andrejsoucek/louvre-motor/mount.stl

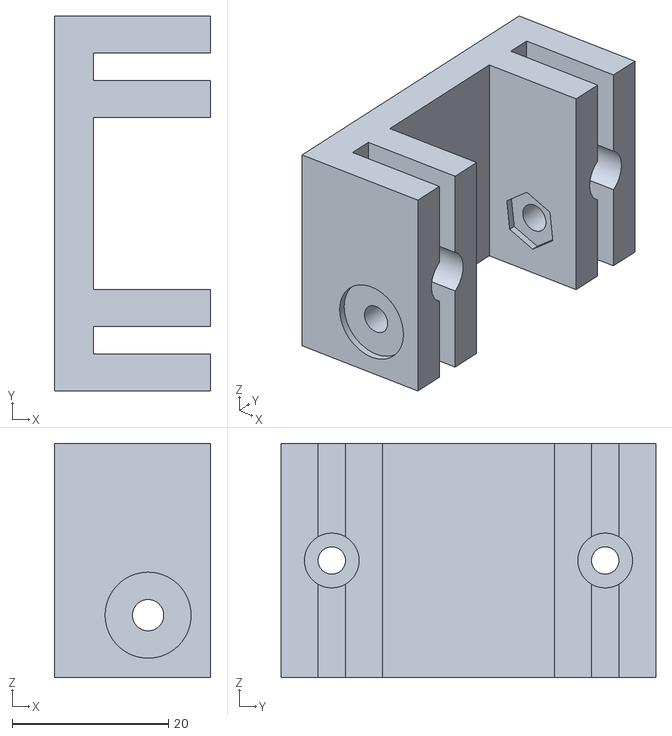
[picture p1: CAD file, 2026-07-16]
mount.stl
20.0 x 48.0 x 30.0
