andrejsoucek/louvre-motor/adapter-motor.stl

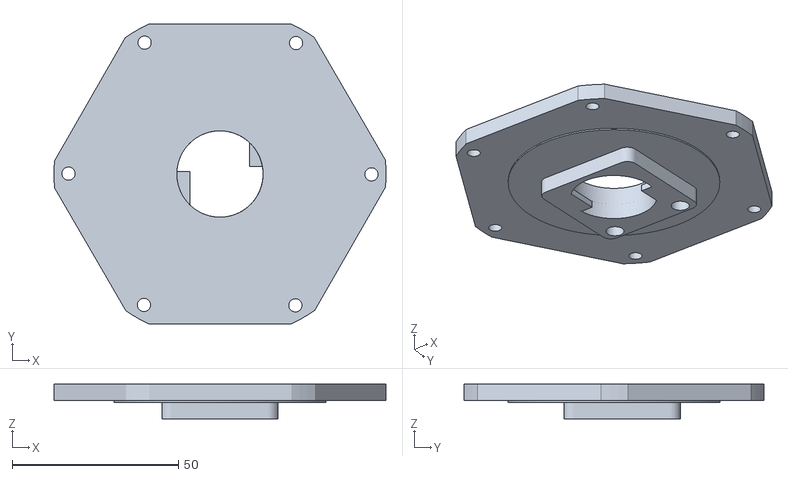
[picture p2: CAD file, 2026-07-16]
adapter-motor.stl
100.0 x 90.5 x 10.5
