andrejsoucek/louvre-motor/cover_no_holes.stl

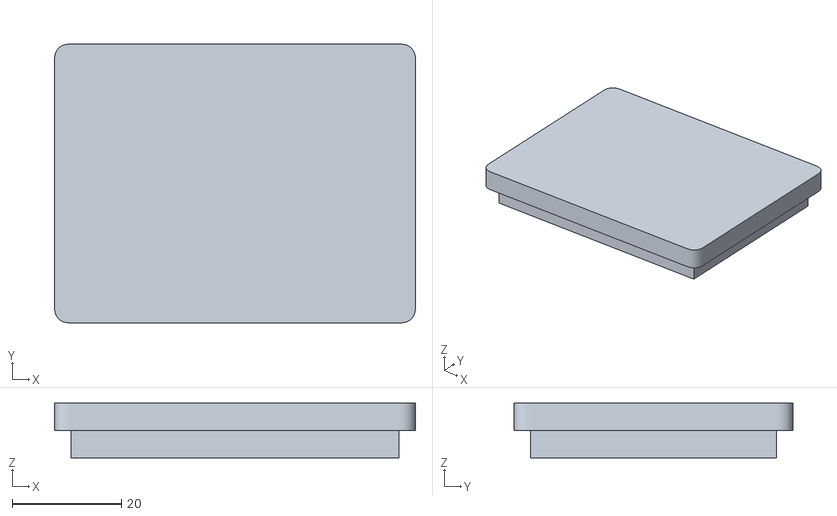
[picture p3: CAD file, 2026-07-16]
cover_no_holes.stl
66.0 x 51.0 x 10.0
