andrejsoucek/louvre-motor/spacer.stl

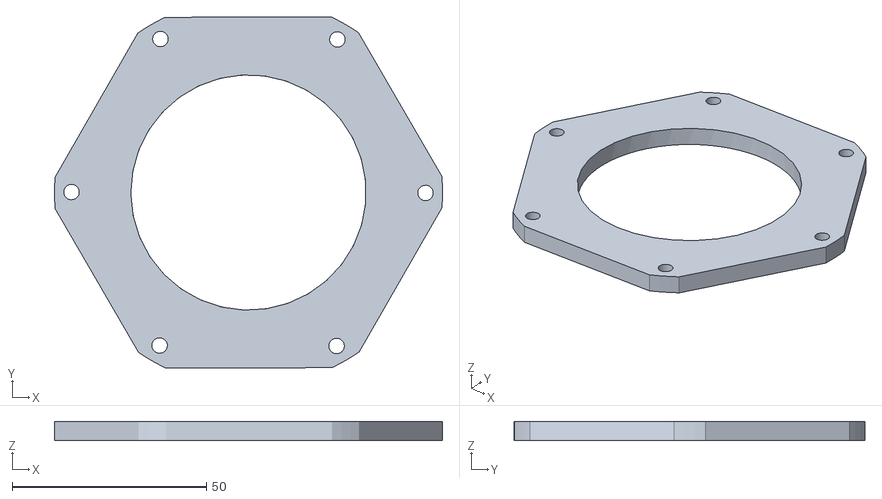
[picture p4: CAD file, 2026-07-16]
spacer.stl
100.0 x 90.5 x 5.00
