andrejsoucek/louvre-motor/sn04n_mount.stl

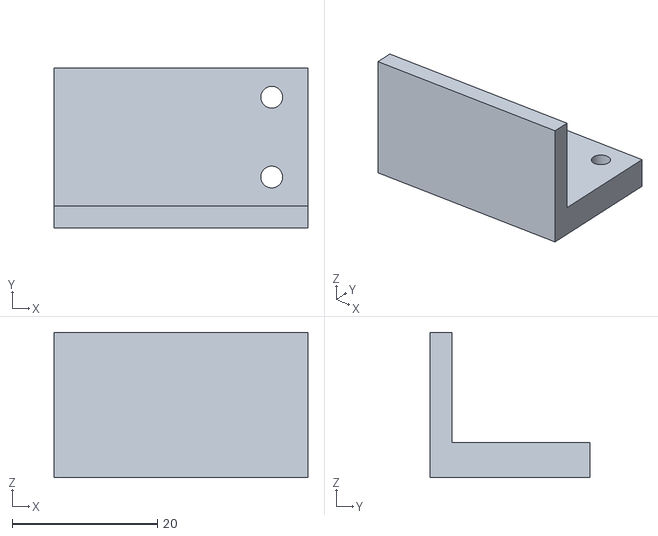
[picture p5: CAD file, 2026-07-16]
sn04n_mount.stl
35.0 x 22.0 x 20.0
