andrejsoucek/louvre-motor/cover.stl

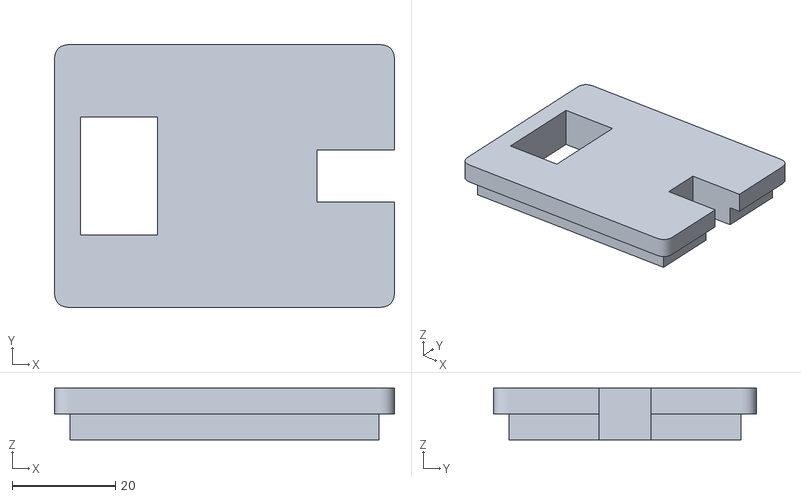
[picture p6: CAD file, 2026-07-16]
cover.stl
66.0 x 51.0 x 10.0
