andrejsoucek/louvre-motor/kola.3mf

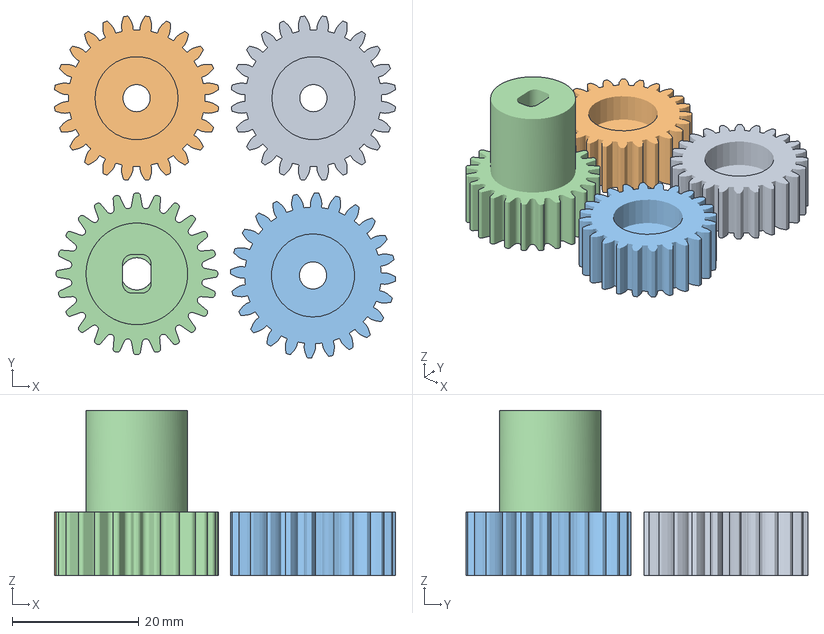
[picture p7: CAD file, 2026-07-16]
kola.3mf
53.7 x 53.9 x 26.0 mm
Body1_2.stl
Body1_3.stl
Body1_1.stl
motor-gear.stl
