andrejsoucek/louvre-motor/case2.stl

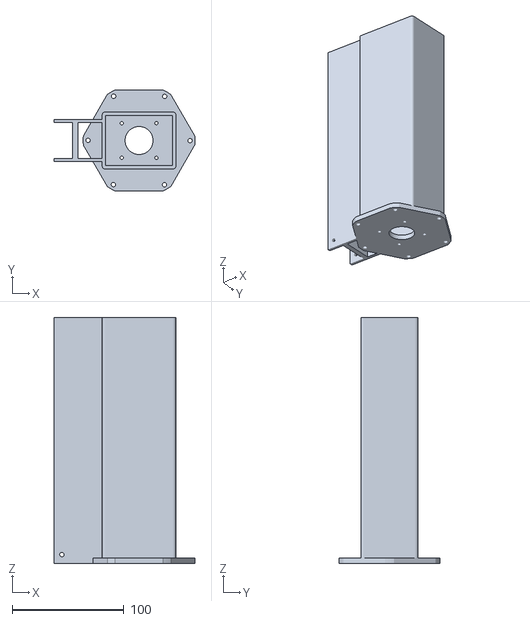
[picture p8: CAD file, 2026-07-16]
case2.stl
126.0 x 90.5 x 220.0
