andrejsoucek/louvre-motor/motor-gear.stl

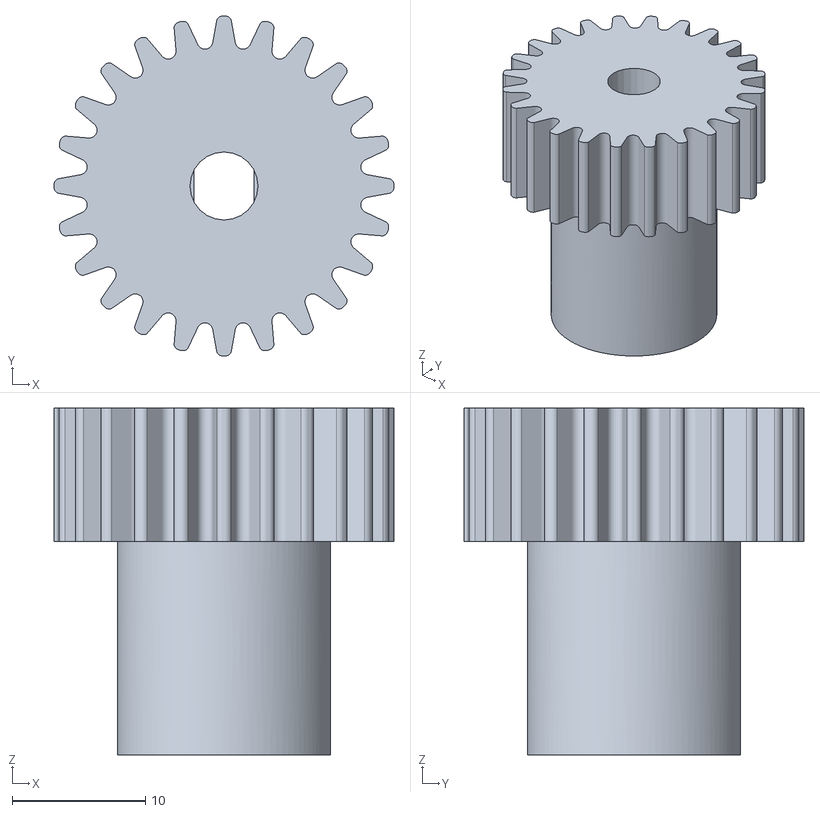
[picture p9: CAD file, 2026-07-16]
motor-gear.stl
25.5 x 25.5 x 26.0
