andrejsoucek/louvre-motor/(commit log)

2026-07-13 switch to esphome
    [pergola-motor.yaml]
2026-07-16 add stl
    [adapter-motor.stl, case2.stl, cover.stl, cover_no_holes.stl, kola.3mf, motor-gear.stl, mount.stl, sn04n_mount.stl]
